Jianan-Li/Bus-Stop-Kiosk/Electrical Design/Bus Stop Kiosk PCB Rev. 1/Bus Stop Kiosk PCB Rev.1 BOM.xlsx

PCB Rev. 1 Bill of Material
Ref Des | Manufacturer P/N | Manufacturer | Description | Package
R1 | LRMAM1206-R001FT5 | TT Electronics/Welwyn | RES SMD 0.001 OHM 1% 1W | 1206
R2, R13 | RC0603FR-07100KL | Yageo | RES SMD 100K OHM 1% 1/10W | 0603
R3 | RC0603FR-071K07L | Yageo | RES SMD 1.07K OHM 1% 1/10W | 0603
R4 | RC0603FR-075K62L | Yageo | RES SMD 5.62K OHM 1% 1/10W | 0603
R5 | RC0603FR-071M21L | Yageo | RES SMD 1.21M OHM 1% 1/10W | 0603
R6 | RC0603FR-07383KL | Yageo | RES SMD 383K OHM 1% 1/10W | 0603
R7, R8, R12, R14 | RC0603FR-0710KL | Yageo | RES SMD 10K OHM 1% 1/10W | 0603
R9 | RC0603FR-0768KL | Yageo | RES SMD 68K OHM 1% 1/10W | 0603
R10, R11 | RC0603FR-07330RL | Yageo | RES SMD 330 OHM 1% 1/10W | 0603
C1, C16, C18, C20 | CC0603KRX7R8BB104 | Yageo | CAP CER 0.1UF 25V X7R | 0603
C2 | EEE-FK1H151P | Panasonic | CAP ALUM 150UF 20% 50V | Radial, Can
C3, C4, C5 | UMK325BJ106MM-T | Taiyo Yuden | CAP CER 10UF 50V X5R | 1210
C6, C9 | CC1206KRX7R9BB473 | Yageo | CAP CER 0.047UF 50V X7R | 1206
C7 | CC0603KRX7R8BB474 | Yageo | CAP CER 0.47UF 25V X7R | 0603
C8 | CC0603KRX7R9BB472 | Yageo | CAP CER 4700PF 50V X7R | 0603
C10 | GRM32ER61A476KE20L | Murata | CAP CER 47UF 10V X5R | 1210
C11, C12 | T520D337M006ATE015 | Kemet | CAP TANT POLY 330UF 6.3V | 2917 (D)
C13 | CC1210MKX7R8BB226 | Yageo | CAP CER 22UF 25V X7R | 1210
C14 | CC0603KRX7R9BB332 | Yageo | CAP CER 3300PF 50V X7R | 0603
C15 | LMK212BJ226MG-T | Taiyo Yuden | CAP CER 22UF 10V X5R | 0805
C17, C19 | CC0603KRX7R8BB105 | Yageo | CAP CER 1UF 25V X7R | 0603
C21, C22 | CC0603JRNPO9BN220 | Yageo | CAP CER 22PF 50V NPO | 0603
D1 | LTST-C195KGJRKT | Lite-On Inc. | LED GREEN/RED CLEAR 0606 | 0606
Q1 | PT17-21C/L41/TR8 | Everlight Electronics Co Ltd | PHOTOTRANSISTOR FLAT CLEAR | 0805
Y1 | ABM8G-16.000MHZ-18-D2Y-T | Abracon LLC | Crystal 16.0000MHz 20ppm 18pF | 4-SMD
U1 | INA226AIDGSR | Texas Instruments | IC MONITOR PWR/CURR BIDIR | 10-MSOP
U2 | LMZ22010TZ/NOPB | Texas Instruments | IC BUCK SYNC 20V 10A | TO-PMOD-11
U3 | LMZ21701SILT | Texas Instruments | DC/DC CONVERTER 0.9-6V 6W | 8-SMD
U4 | IMP002-S-US-TR | Electric Imp Inc. | IMP 802.11B/G/N NODE MODULE | 35-SMD
U5 | ATMEGA328P-AU | Atmel | IC MCU 8BIT 32KB FLASH | 32-TQFP
S1 | KSC241JLFS | C&K Components | SWITCH TACTILE SPST-NO 0.05A 32V
J1, J2 | OSTOQ025351 | On Shore Technology Inc. | TERM BLOCK HDR 2POS R/A 5.08MM
J3, J4, J5 | B4B-XH-A(LF)(SN) | JST Sales America Inc. | CONN HEADER XH TOP 4POS 2.5MM
J6 | 302-S161 | On Shore Technology Inc. | CONN HEADER VERT 16POS GOLD
J7 | 67996-406HLF | FCI | CONN HEADER 6POS .100 STR TIN
PCB Rev. 2 Bill of Material
Ref Des | Manufacturer P/N | Manufacturer | Description | Package
R1, R15. R16 | LRMAM1206-R001FT5 | TT Electronics/Welwyn | RES SMD 0.001 OHM 1% 1W | 1206
R2, R17, R22, R28 | RC0603FR-07100KL | Yageo | RES SMD 100K OHM 1% 1/10W | 0603
R3, R23, R27, R29, R30 | RC0603FR-0710KL | Yageo | RES SMD 10K OHM 1% 1/10W | 0603
R4, R5 | RC0402FR-075K1L | Yageo | RES SMD 5.1K OHM 1% 1/16W | 0402
R6 | RC0402FR-07536KL | Yageo | RES SMD 536K OHM 1% 1/16W | 0402
R7, R9 | RC0402FR-07100KL | Yageo | RES SMD 100K OHM 1% 1/16W | 0402
R8 | RMCF0402FT1M20 | Stackpole Electronics Inc. | RES SMD 1.2M OHM 1% 1/16W | 0402
R10 | RMCF0402FT1M00 | Stackpole Electronics Inc. | RES SMD 1M OHM 1% 1/16W | 0402
R11 | RL1206FR-070R05L | Yageo | RES SMD 0.05 OHM 1% 1/4W | 1206
R12 | ERA-3AEB3163V | Panasonic Electronic Components | RES SMD 316K OHM 0.1% 1/10W | 0603
R13 | RC0402FR-07174KL | Yageo | RES SMD 174K OHM 1% 1/16W | 0402
R14 | RT0603BRD07100KL | Yageo | RES SMD 100K OHM 0.1% 1/10W | 0603
R18 | RC0603FR-071K07L | Yageo | RES SMD 1.07K OHM 1% 1/10W | 0603
R19 | RC0603FR-075K76L | Yageo | RES SMD 5.76K OHM 1% 1/10W | 0603
R20 | RC0603FR-071M21L | Yageo | RES SMD 1.21M OHM 1% 1/10W | 0603
R21 | RC0603FR-07383KL | Yageo | RES SMD 383K OHM 1% 1/10W | 0603
R24 | RC0603FR-0768KL | Yageo | RES SMD 68K OHM 1% 1/10W | 0603
R25, R26 | RC0603FR-07330RL | Yageo | RES SMD 330 OHM 1% 1/10W | 0603
C1, C11, C12, C25, C28, C30, C32 | CC0603KRX7R8BB104 | Yageo | CAP CER 0.1UF 25V X7R | 0603
C2, C3, C4 | T521X107M025ATE060 | Kemet | CAP TANTALUM 100UF 25V | 2917 (D)
C5, C7, C14, C15 | UMK325BJ106MM-T | Taiyo Yuden | CAP CER 10UF 50V X5R | 1210
C6 | UMK212B7105KG-T | Taiyo Yuden | CAP CER 1UF 50V X7R | 0805
C8 | CC0603KRX5R5BB475 | Yageo | CAP CER 4.7UF 6.3V X5R | 0603
C9, C10 | T521D107M020ATE055 | Kemet | CAP TANTALUM 100UF 20V | 2917 (D)
C13 | EEE-FK1H151P | Panasonic | CAP ALUM 150UF 20% 50V | Radial, Can
C16 | CC0603KRX7R8BB474 | Yageo | CAP CER 0.47UF 25V X7R | 0603
C17 | CC0603KRX7R9BB472 | Yageo | CAP CER 4700PF 50V X7R | 0603
C18 | CC1206KRX7R9BB473 | Yageo | CAP CER 0.047UF 50V X7R | 1206
C19 | GRM32ER61A476KE20L | Murata | CAP CER 47UF 10V X5R | 1210
C20, C21 | T520D337M006ATE015 | Kemet | CAP TANT POLY 330UF 6.3V | 2917 (D)
C22 | CC1210MKX7R8BB226 | Yageo | CAP CER 22UF 25V X7R | 1210
C23 | LMK212BJ226MG-T | Taiyo Yuden | CAP CER 22UF 10V X5R | 0805
C24 | CC0603KRX7R9BB332 | Yageo | CAP CER 3300PF 50V X7R | 0603
C26, C27 | CC0603JRNPO9BN220 | Yageo | CAP CER 22PF 50V NPO | 0603
C29, C31 | CC0603KRX7R8BB105 | Yageo | CAP CER 1UF 25V X7R | 0603
L1 | XAL6060-103MEB | Coilcraft | Power Inductor 10UH | 6060
F1, F2 | 0603SFP400F/32-2 | TE Connectivity Raychem Circuit Protection | FUSE BOARD MOUNT 4A 32VDC | 0603
D1 | CMHZ4697 TR | Central Semiconductor Corp | DIODE ZENER 10V 500MW | SOD-123
D2 | LTST-C191KGKT | Lite-On Inc. | LED GREEN CLEAR | 0603
D3 | LTST-C191KRKT | Lite-On Inc. | LED RED CLEAR | 0603
D4 | CMSH3-40MA TR13 | Central Semiconductor Corp | DIODE SCHOTTKY 40V 3A | SMA
D5, D7 | 1N4148W-7-F | Diodes Incorporated | DIODE GEN PURP 100V 300MA | SOD-123
D6 | CMHZ4691 TR | Central Semiconductor Corp | DIODE ZENER 6.2V 500MW | SOD-123
D8 | LTST-C195KGJRKT | Lite-On Inc. | LED GREEN/RED CLEAR 0606 | 0606
Q1 | SI2319CDS-T1-GE3 | Vishay Siliconix | MOSFET P-CH 40V 4.4A | SOT-23
Q2 | PT17-21C/L41/TR8 | Everlight Electronics Co Ltd | PHOTOTRANSISTOR FLAT CLEAR | 0805
Y1 | ABM8G-16.000MHZ-18-D2Y-T | Abracon LLC | Crystal 16.0000MHz 20ppm 18pF | 4-SMD
U1, U3, U4 | INA226AIDGSR | Texas Instruments | IC MONITOR PWR/CURR BIDIR | 10-MSOP
U2 | LT3652IMSE#PBF | Linear Technology | IC BATT CHARGER SOLAR 2A 12MSOP | 12-MSOP-EP
U5 | LMZ12010TZ/NOPB | Texas Instruments | IC BUCK SYNC 20V 10A | TO-PMOD-11
U6 | LMZ21701SILT | Texas Instruments | DC/DC CONVERTER 0.9-6V 6W | 8-SMD
U7 | ATMEGA328P-AU | Atmel | IC MCU 8BIT 32KB FLASH | 32-TQFP
U8 | IMP002-S-US-TR | Electric Imp Inc. | IMP 802.11B/G/N NODE MODULE | 35-SMD
U9 | 568-5479-1-ND | NXP Semiconductors | TXRX TRANSLATING 3ST 8VSSOP | 8-VSSOP
S1 | KSC241JLFS | C&K Components | SWITCH TACTILE SPST-NO 0.05A 32V
J1, J2, J4 | OSTOQ025351 | On Shore Technology Inc. | TERM BLOCK HDR 2POS R/A 5.08MM
J3 | OSTOQ045451 | On Shore Technology Inc. | TERM BLOCK HDR 4POS R/A 5.08MM
J5, J6, J7 | B4B-XH-A(LF)(SN) | JST Sales America Inc. | CONN HEADER XH TOP 4POS 2.5MM
J8 | 302-S161 | On Shore Technology Inc. | CONN HEADER VERT 16POS GOLD
J9 | 67996-406HLF | FCI | CONN HEADER 6POS .100 STR TIN
