Jianan-Li/Bus-Stop-Kiosk/Mechanical Design/LED Matrix Enclosure/LED Frame Assembly.SLDASM

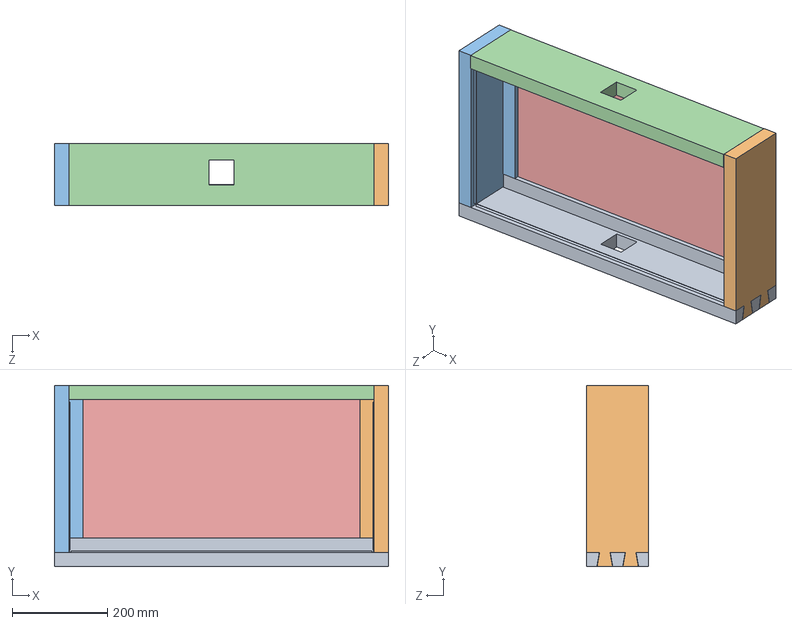
[picture p1: CAD file, 2016-12-03]
Mechanical Design/LED Matrix Enclosure/LED Frame Assembly.SLDASM
700.1 x 380.0 x 131.0 mm
Bottom
Right
Left
Top
Back
