Jianan-Li/Bus-Stop-Kiosk/Mechanical Design/Bus Map Enclosure/Assem1.SLDASM

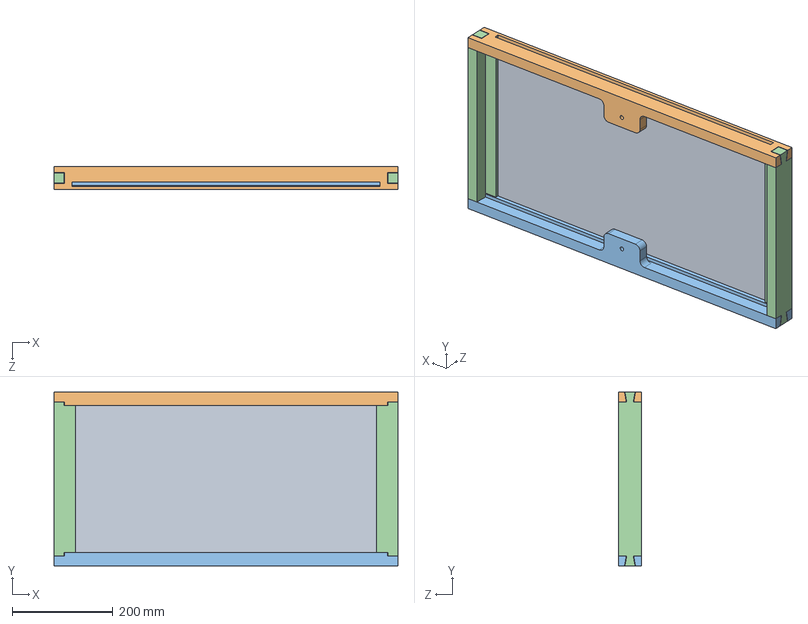
[picture p2: CAD file, 2016-12-03]
Mechanical Design/Bus Map Enclosure/Assem1.SLDASM
682.7 x 344.8 x 46.0 mm
Plexiglass
MapTop
MapBottom
MapSide x 2
