Jianan-Li/Bus-Stop-Kiosk/Mechanical Design/Bus Map Enclosure/MapTop.sldprt

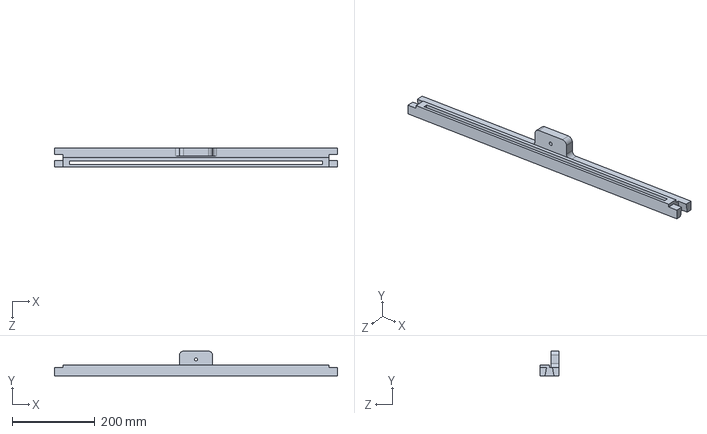
[picture p3: CAD file, 2016-12-03]
Mechanical Design/Bus Map Enclosure/MapTop.sldprt
682.7 x 60.0 x 46.0 mm
