Jianan-Li/Bus-Stop-Kiosk/Mechanical Design/LED Matrix Enclosure/Bottom.SLDPRT

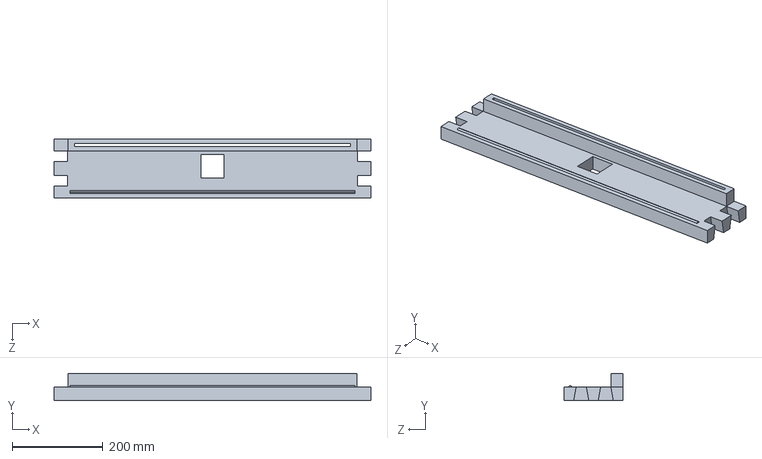
[picture p4: CAD file, 2016-12-03]
Mechanical Design/LED Matrix Enclosure/Bottom.SLDPRT
700.0 x 60.0 x 130.0 mm
