Jianan-Li/Bus-Stop-Kiosk/Mechanical Design/Bus Map Enclosure/MapSide.SLDPRT

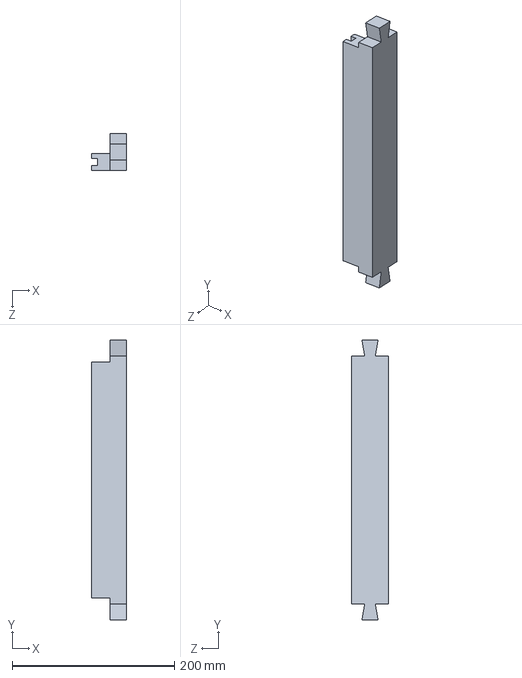
[picture p5: CAD file, 2016-12-03]
Mechanical Design/Bus Map Enclosure/MapSide.SLDPRT
42.9 x 344.8 x 46.0 mm
