Jianan-Li/Bus-Stop-Kiosk/Mechanical Design/LED Matrix Enclosure/Left.SLDPRT

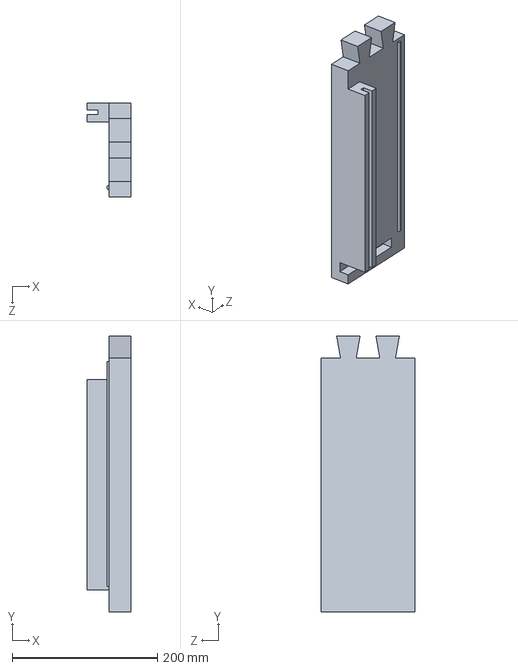
[picture p6: CAD file, 2016-12-03]
Mechanical Design/LED Matrix Enclosure/Left.SLDPRT
60.0 x 380.0 x 130.0 mm
