Jianan-Li/Bus-Stop-Kiosk/Mechanical Design/Bus Map Enclosure/Plexiglass.SLDPRT

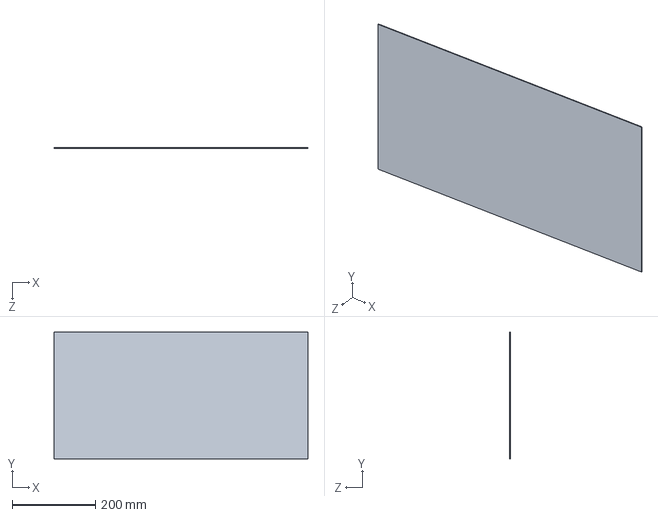
[picture p7: CAD file, 2016-12-03]
Mechanical Design/Bus Map Enclosure/Plexiglass.SLDPRT
609.6 x 304.8 x 1.59 mm
