Jianan-Li/Bus-Stop-Kiosk/Mechanical Design/LED Matrix Enclosure/Back.SLDPRT

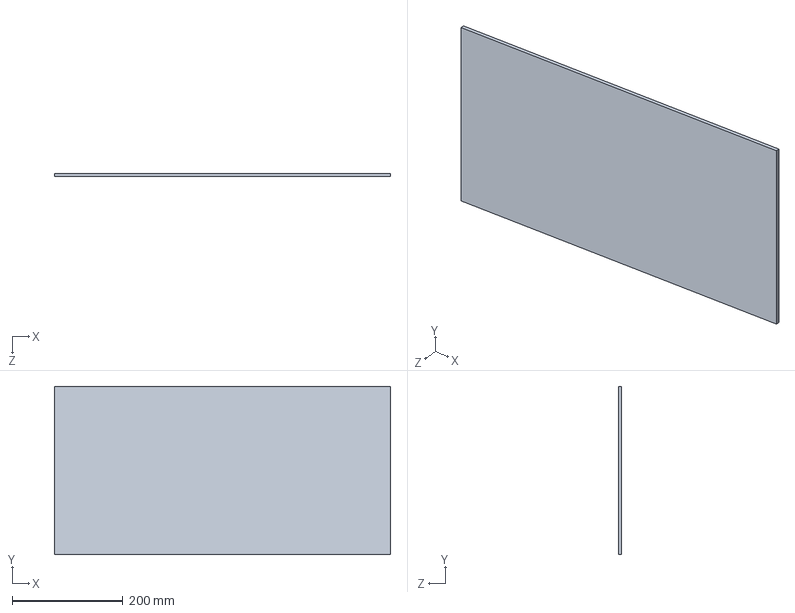
[picture p8: CAD file, 2016-12-03]
Mechanical Design/LED Matrix Enclosure/Back.SLDPRT
608.0 x 304.0 x 6.30 mm
