Jianan-Li/Bus-Stop-Kiosk/Mechanical Design/Bus Map Enclosure/MapBottom.sldprt

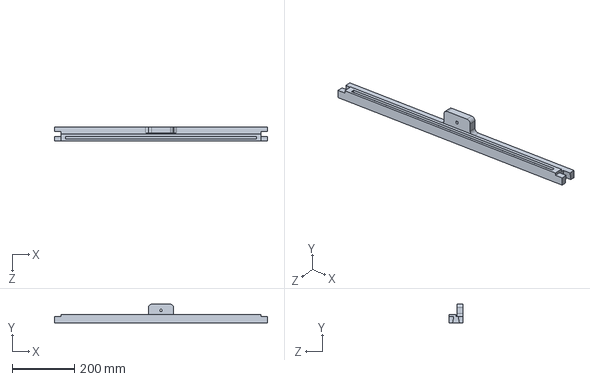
[picture p9: CAD file, 2016-12-03]
Mechanical Design/Bus Map Enclosure/MapBottom.sldprt
682.7 x 60.0 x 46.0 mm
