Jianan-Li/Bus-Stop-Kiosk/Mechanical Design/LED Matrix Enclosure/Top.SLDPRT

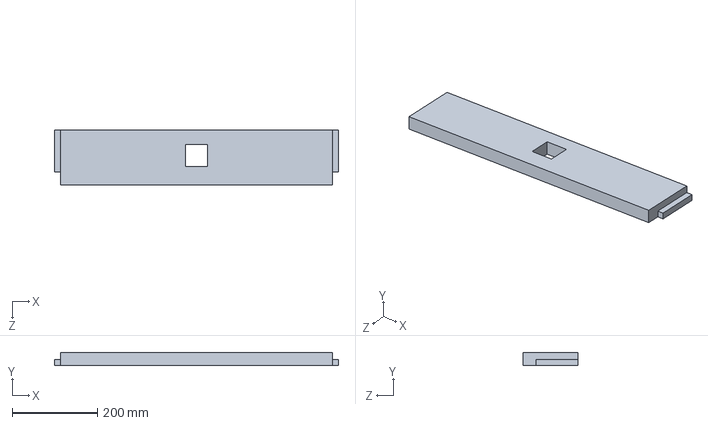
[picture p10: CAD file, 2016-12-03]
Mechanical Design/LED Matrix Enclosure/Top.SLDPRT
668.0 x 30.0 x 130.0 mm
