Jianan-Li/Bus-Stop-Kiosk/(list of files, cad)

Other CAD files:
Mechanical Design/LED Matrix Enclosure/Right.SLDPRT
