Jianan-Li/Bus-Stop-Kiosk/Electrical Design/Bus Stop Kiosk PCB Rev. 1/Bus Stop Kiosk Rev. 1.brd

## EAGLE design Electrical Design/Bus Stop Kiosk PCB Rev. 1/Bus Stop Kiosk Rev. 1.brd (2016-12-03)

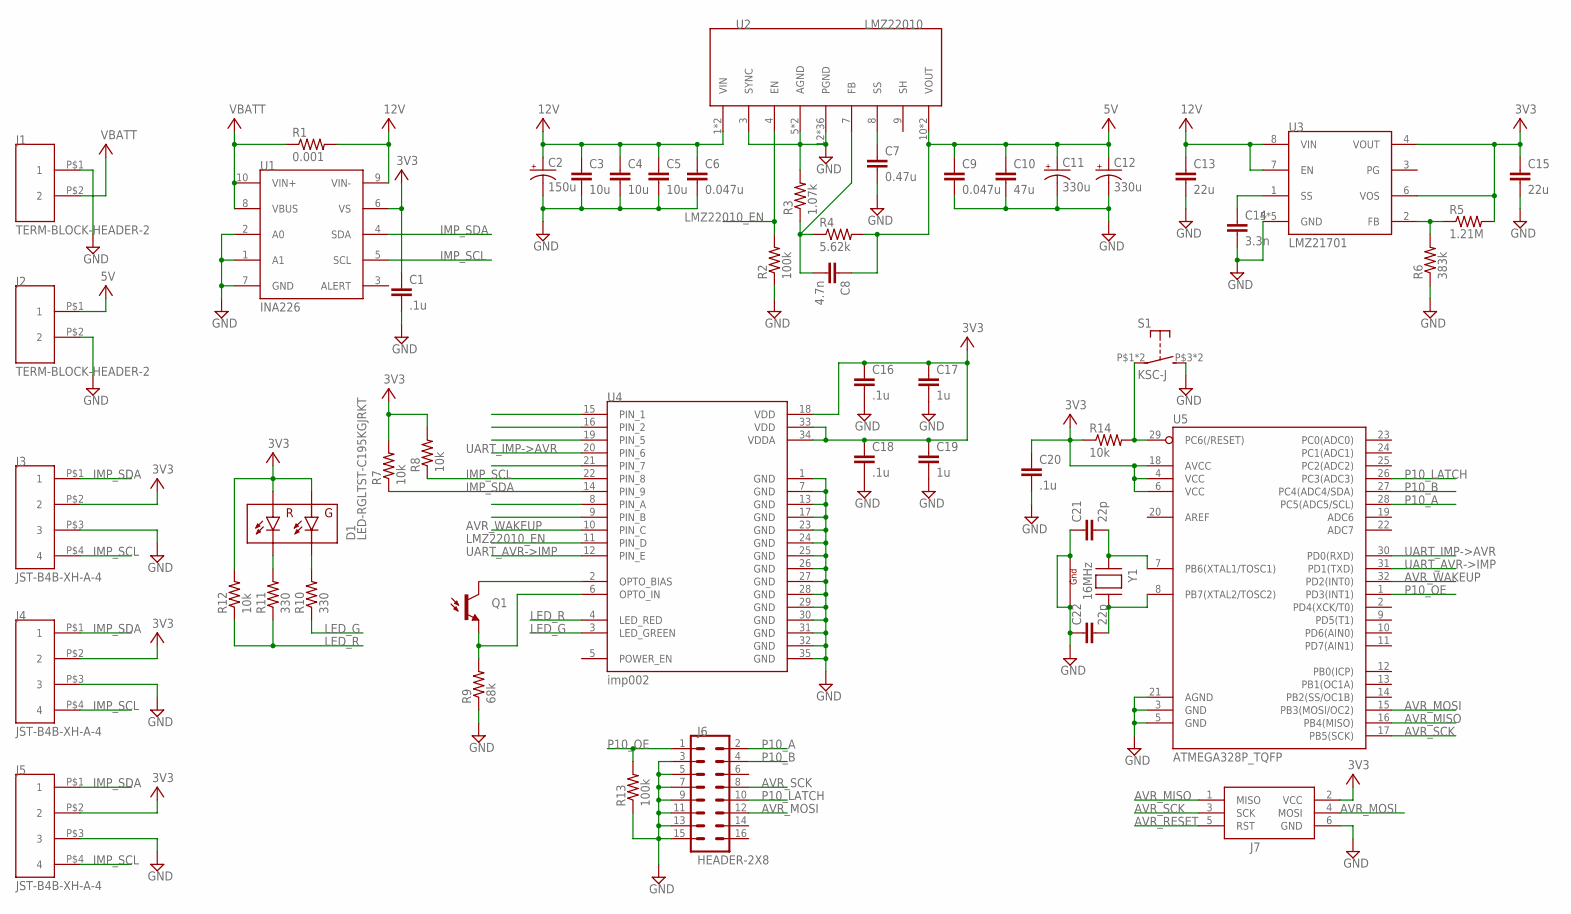
[picture p11: schematic Bus Stop Kiosk Rev. 1.sch]

Parts:
C1, C16, C18, C20: .1u; C0603K
C2: 150u; PANASONIC_G
C3, C4, C5: 10u; C1210K
C6, C9: 0.047u; C1206K
C7: 0.47u; C0603K
C8: 4.7n; C0603K
C10: 47u; C1210K
C11, C12: 330u; EIA7343
C13: 22u; C1210K
C14: 3.3n; C0603K
C15: 22u; C0805K
C17, C19: 1u; C0603K
C21, C22: 22p; C0603K
D1: LED-RGLTST-C195KGJRKT; LTST-C195KGJRKT
J1, J2: TERM-BLOCK-HEADER-2; TERM-BLOCK-HDR-2
J3, J4, J5: JST-B4B-XH-A-4
J6: HEADER-2X8; HEADER-2X8-SHROUDED
J7: AVRISP-6; AVRISP
Q1: PHOTOTRANSISTORPT17-21C-L41-TR8; PT17-21C-L41-TR8
R1: 0.001; R1206
R2, R13: 100k; R0603
R3: 1.07k; R0603
R4: 5.62k; R0603
R5: 1.21M; R0603
R6: 383k; R0603
R7, R8, R12, R14: 10k; R0603
R9: 68k; R0603
R10, R11: 330; R0603
S1: KSC-J; C&K-KSC
U1: INA226; VSSOP-10
U2: LMZ22010; TO-PMOD-11
U3: LMZ21701; SIL0008E
U4: imp002; ELECTRIC_IMP_IMP002
U5: ATMEGA328P_TQFP; TQFP32-08
Y1: 16MHz; NX3225

Connections:
3V3: C1.1, C15.1, C16.1, C17.1, C18.1, C19.1, C20.1, D1.P$1 (GA), D1.P$2 (RA), J3.P$2 (2), J4.P$2 (2), J5.P$2 (2), J7.2 (VCC), R5.2, R7.2, R8.2, R12.2, R14.1, U1.6 (VS), U3.4 (VOUT), U3.6 (VOS), U4.18 (VDD), U4.33 (VDD), U4.34 (VDDA), U5.4 (VCC), U5.6 (VCC), U5.18 (AVCC)
5V: C8.1, C9.1, C10.1, C11.A (+), C12.A (+), J2.P$1 (1), R4.2, U2.10 (VOUT), U2.11 (VOUT)
12V: C2.+, C3.1, C4.1, C5.1, C6.1, C13.1, R1.2, U1.9 (VIN-), U2.1 (VIN), U2.2 (VIN), U3.7 (EN), U3.8 (VIN)
ADC1: U4.8 (PIN_A)
ADC2: U4.9 (PIN_B)
AVR_MISO: J7.1 (MISO), U5.16 (PB4(MISO))
AVR_MOSI: J6.12, J7.4 (MOSI), U5.15 (PB3(MOSI/OC2))
AVR_RESET: J7.5 (RST), R14.2, S1.P$1, S1.P$2, U5.29 (PC6(/RESET))
AVR_SCK: J6.8, J7.3 (SCK), U5.17 (PB5(SCK))
AVR_WAKEUP: U4.10 (PIN_C), U5.32 (PD2(INT0))
C21: C21.2, U5.7 (PB6(XTAL1/TOSC1)), Y1.1 (X1)
GND: C1.2, C2.-, C3.2, C4.2, C5.2, C6.2, C7.2, C9.2, C10.2, C11.C (-), C12.C (-), C13.2, C14.2, C15.2, C16.2, C17.2, C18.2, C19.2, C20.2, C21.1, C22.1, J1.P$1 (1), J2.P$2 (2), J3.P$3 (3), J4.P$3 (3), J5.P$3 (3), J6.3, J6.5, J6.7, J6.9, J6.11, J6.13, J6.15, J7.6 (GND), R2.1, R3.2, R6.1, R9.1, R13.1, S1.P$3 (S), S1.P$4 (S), U1.1 (A1), U1.2 (A0), U1.7 (GND), U2.3 (SYNC), U2.5 (AGND), U2.6 (AGND), U2.12 (PGND), U2.P$1 (PGND), U2.P$2 (PGND), U2.P$3 (PGND), U2.P$4 (PGND), U2.P$5 (PGND), U2.P$6 (PGND), U2.P$7 (PGND), U2.P$8 (PGND), U2.P$9 (PGND), U2.P$10 (PGND), U2.P$11 (PGND), U2.P$12 (PGND), U2.P$13 (PGND), U2.P$14 (PGND), U2.P$15 (PGND), U2.P$16 (PGND), U2.P$17 (PGND), U2.P$18 (PGND), U2.P$19 (PGND), U2.P$20 (PGND), U2.P$21 (PGND), U2.P$22 (PGND), U2.P$23 (PGND), U2.P$24 (PGND), U2.P$25 (PGND), U2.P$26 (PGND), U2.P$27 (PGND), U2.P$28 (PGND), U2.P$29 (PGND), U2.P$30 (PGND), U2.P$31 (PGND), U2.P$32 (PGND), U2.P$33 (PGND), U2.P$34 (PGND), U2.P$35 (PGND), U3.5 (GND), U3.9 (GND), U3.10 (GND), U3.11 (GND), U3.12 (GND), U4.1 (GND), U4.7 (GND), U4.13 (GND), U4.17 (GND), U4.23 (GND), U4.24 (GND), U4.25 (GND), U4.26 (GND), U4.27 (GND), U4.28 (GND), U4.29 (GND), U4.30 (GND), U4.31 (GND), U4.32 (GND), U4.35 (GND), U5.3 (GND), U5.5 (GND), U5.21 (AGND), Y1.2 (G2), Y1.4 (G1)
IMP_SCL: J3.P$4 (4), J4.P$4 (4), J5.P$4 (4), R8.1, U1.5 (SCL), U4.22 (PIN_8)
IMP_SDA: J3.P$1 (1), J4.P$1 (1), J5.P$1 (1), R7.1, U1.4 (SDA), U4.14 (PIN_9)
LED_G: R10.1, U4.3 (LED_GREEN)
LED_R: R11.1, R12.1, U4.4 (LED_RED)
LMZ22010_EN: R2.2, U2.4 (EN), U4.11 (PIN_D)
unnamed: Q1.C, U4.2 (OPTO_BIAS)
unnamed: Q1.E, R9.2, U4.6 (OPTO_IN)
unnamed: D1.P$3 (GC), R10.2
unnamed: D1.P$4 (RC), R11.2
unnamed: C14.1, U3.1 (SS)
unnamed: C8.2, R3.1, R4.1, U2.7 (FB)
unnamed: C7.1, U2.8 (SS)
unnamed: R5.1, R6.2, U3.2 (FB)
unnamed: C22.2, U5.8 (PB7(XTAL2/TOSC2)), Y1.3 (X2)
P10_A: J6.2, U5.28 (PC5(ADC5/SCL))
P10_B: J6.4, U5.27 (PC4(ADC4/SDA))
P10_LATCH: J6.10, U5.26 (PC3(ADC3))
P10_OE: J6.1, R13.2, U5.1 (PD3(INT1))
UART_AVR->IMP: U4.12 (PIN_E), U5.31 (PD1(TXD))
UART_IMP->AVR: U4.20 (PIN_6), U5.30 (PD0(RXD))
VBATT: J1.P$2 (2), R1.1, U1.8 (VBUS), U1.10 (VIN+)

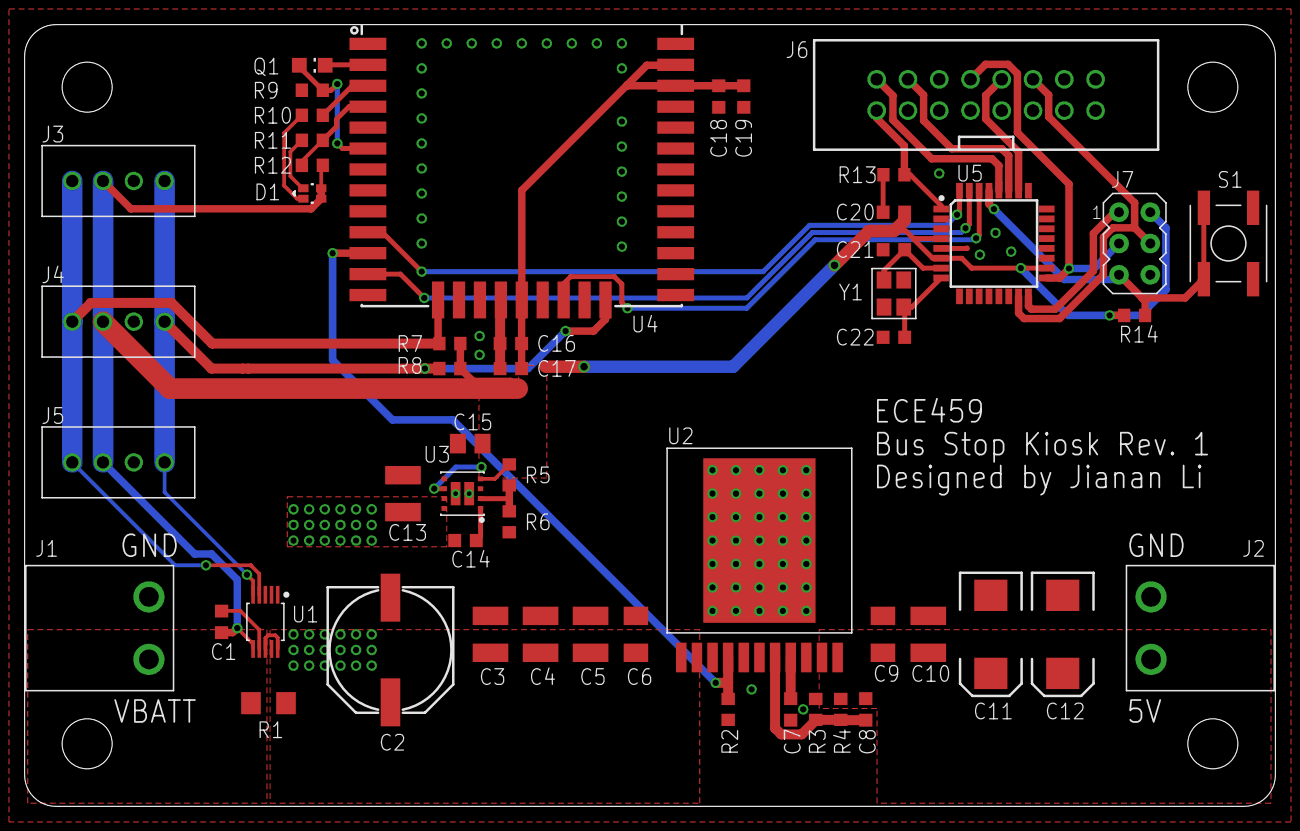
[picture p12: board Bus Stop Kiosk Rev. 1.brd from above]

Board: 2 copper layers, 101.6 x 63.5 mm, 52 parts (0 on the bottom side), 31 nets.
