Jianan-Li/Bus-Stop-Kiosk/Electrical Design/Bus Stop Kiosk PCB Rev. 2/Bus Stop Kiosk Rev. 2.brd

## EAGLE design Electrical Design/Bus Stop Kiosk PCB Rev. 2/Bus Stop Kiosk Rev. 2.brd (2016-12-03)

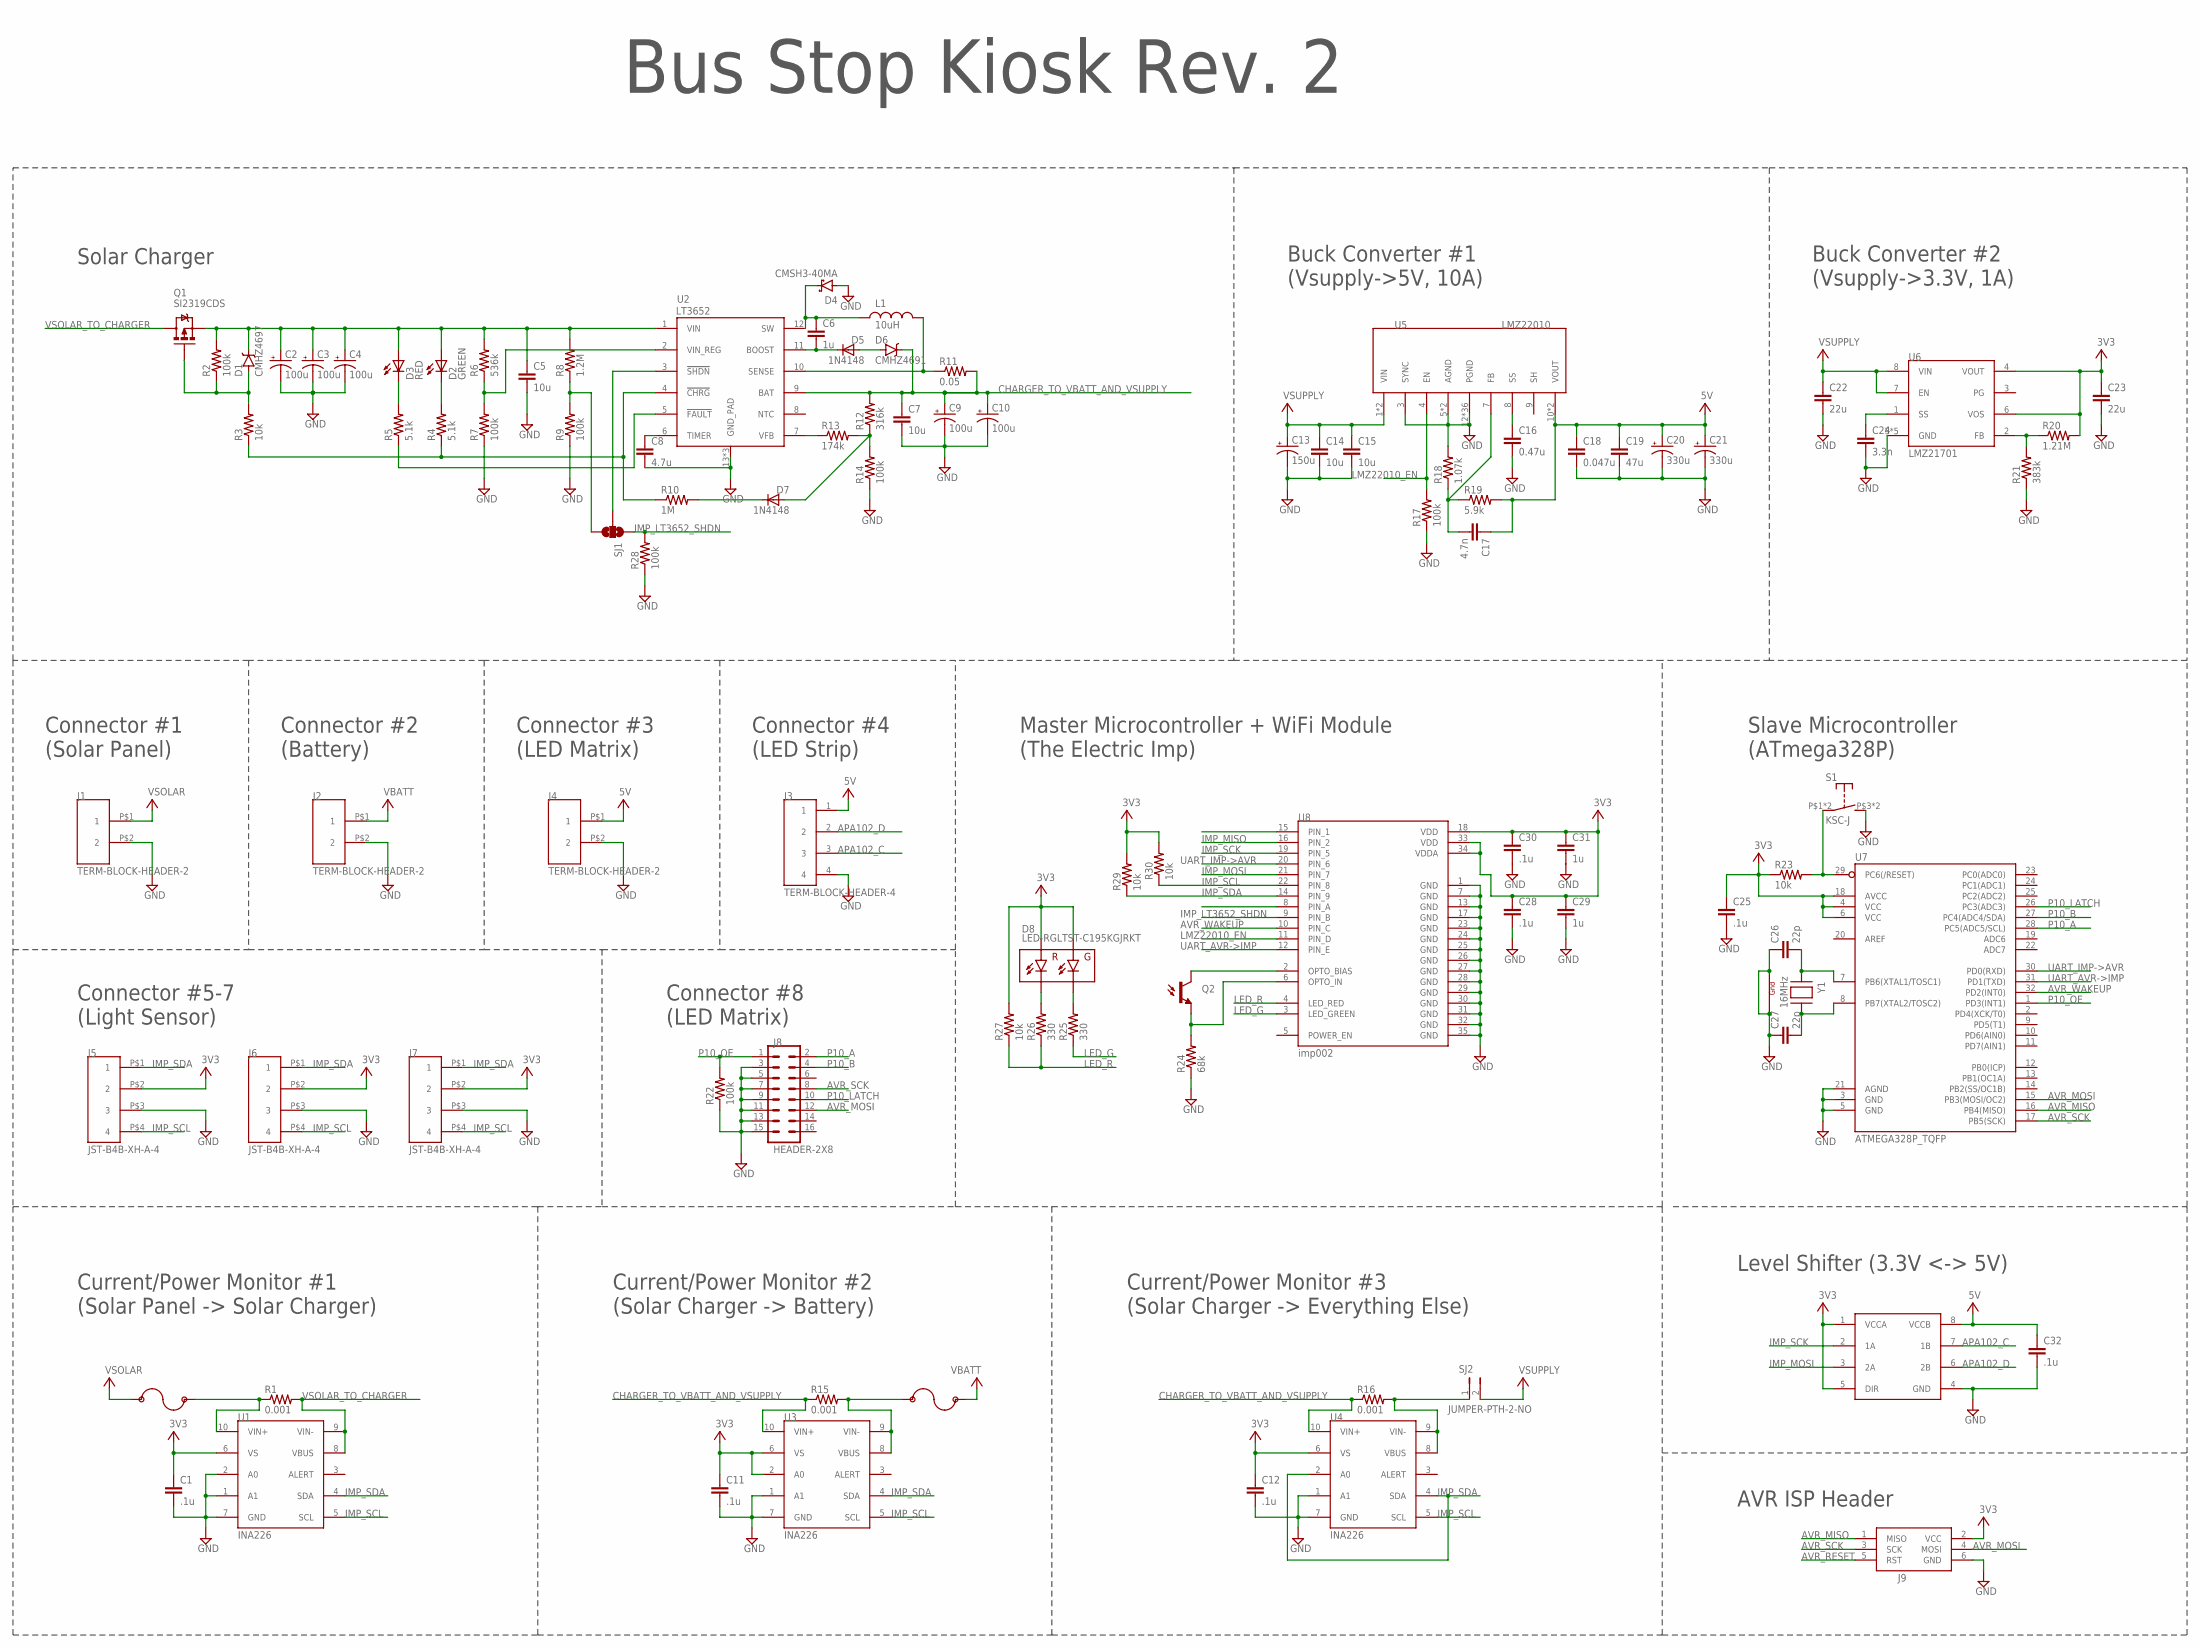
[picture p13: schematic Bus Stop Kiosk Rev. 2.sch]

Parts:
C1, C11, C12, C25, C28, C30, C32: .1u; C0603K
C2, C3, C4, C9, C10: 100u; EIA7343
C5, C7, C14, C15: 10u; C1210K
C6: 1u; C0805K
C8: 4.7u; C0603K
C13: 150u; PANASONIC_G
C16: 0.47u; C0603K
C17: 4.7n; C0603K
C18: 0.047u; C1206K
C19: 47u; C1210K
C20, C21: 330u; EIA7343
C22: 22u; C1210K
C23: 22u; C0805K
C24: 3.3n; C0603K
C26, C27: 22p; C0603K
C29, C31: 1u; C0603K
D1: CMHZ4697; SOD-123
D2: GREEN; CHIP-LED0603
D3: RED; CHIP-LED0603
D4: CMSH3-40MA; SMA-DIODE
D5, D7: 1N4148; SOD-123
D6: CMHZ4691; SOD-123
D8: LED-RGLTST-C195KGJRKT; LTST-C195KGJRKT
F1, F2: 4A; 0603
J1, J2, J4: TERM-BLOCK-HEADER-2; TERM-BLOCK-HDR-2
J3: TERM-BLOCK-HEADER-4; OSTOQ045451
J5, J6, J7: JST-B4B-XH-A-4
J8: HEADER-2X8; HEADER-2X8-SHROUDED
J9: AVRISP-6; AVRISP
L1: 10uH; INDUCTOR-6.86X6.47
Q1: SI2319CDS; SOT-23-3
Q2: PHOTOTRANSISTORPT17-21C-L41-TR8; PT17-21C-L41-TR8
R1, R15, R16: 0.001; R1206
R2, R14, R17, R22, R28: 100k; R0603
R3, R23, R27, R29, R30: 10k; R0603
R4, R5: 5.1k; R0402
R6: 536k; R0402
R7, R9: 100k; R0402
R8: 1.2M; R0402
R10: 1M; R0402
R11: 0.05; R1206
R12: 316k; R0603
R13: 174k; R0402
R18: 1.07k; R0603
R19: 5.9k; R0603
R20: 1.21M; R0603
R21: 383k; R0603
R24: 68k; R0603
R25, R26: 330; R0603
S1: KSC-J; C&K-KSC
SJ1: JUMPER-PAD-3-NOYES_SILK; PAD-JUMPER-3-NO_YES_SILK
SJ2: JUMPER-PTH-2-NO; PTH-JUMPER-2-NO_NO_SILK
U1, U3, U4: INA226; VSSOP-10
U2: LT3652; MSOP-12_GND
U5: LMZ22010; TO-PMOD-11
U6: LMZ21701; SIL0008E
U7: ATMEGA328P_TQFP; TQFP32-08
U8: imp002; ELECTRIC_IMP_IMP002
U9: 74LVC2T45; VSSOP-8
Y1: 16MHz; NX3225

Connections:
3V3: C1.1, C11.1, C12.1, C23.1, C25.1, C28.1, C29.1, C30.1, C31.1, D8.P$1 (GA), D8.P$2 (RA), J5.P$2 (2), J6.P$2 (2), J7.P$2 (2), J9.2 (VCC), R20.2, R23.1, R27.2, R29.2, R30.2, U1.6 (VS), U3.2 (A0), U3.6 (VS), U4.6 (VS), U6.4 (VOUT), U6.6 (VOS), U7.4 (VCC), U7.6 (VCC), U7.18 (AVCC), U8.18 (VDD), U8.33 (VDD), U8.34 (VDDA), U9.1 (VCCA), U9.5 (DIR)
5V: C17.1, C18.1, C19.1, C20.A (+), C21.A (+), C32.1, J3.1, J4.P$1 (1), R19.2, U5.10 (VOUT), U5.11 (VOUT), U9.8 (VCCB)
ADC1: U8.8 (PIN_A)
APA102_C: J3.3, U9.7 (1B)
APA102_D: J3.2, U9.6 (2B)
AVR_MISO: J9.1 (MISO), U7.16 (PB4(MISO))
AVR_MOSI: J8.12, J9.4 (MOSI), U7.15 (PB3(MOSI/OC2))
AVR_RESET: J9.5 (RST), R23.2, S1.P$1, S1.P$2, U7.29 (PC6(/RESET))
AVR_SCK: J8.8, J9.3 (SCK), U7.17 (PB5(SCK))
AVR_WAKEUP: U7.32 (PD2(INT0)), U8.10 (PIN_C)
BOOST: C6.2, D5.C, U2.11 (BOOST)
C21: C26.2, U7.7 (PB6(XTAL1/TOSC1)), Y1.1 (X1)
CHARGER_TO_VBATT_AND_VSUPPLY: C7.1, C9.A (+), C10.A (+), D6.C, R11.2, R12.2, R15.1, R16.1, U2.9 (BAT), U3.10 (VIN+), U4.10 (VIN+)
CHRG: R3.1, R4.1, R10.1, U2.4 (!CHRG)
FAULT: R5.1, U2.5 (!FAULT)
GND: C1.2, C2.C (-), C3.C (-), C4.C (-), C5.2, C7.2, C8.2, C9.C (-), C10.C (-), C11.2, C12.2, C13.-, C14.2, C15.2, C16.2, C18.2, C19.2, C20.C (-), C21.C (-), C22.2, C23.2, C24.2, C25.2, C26.1, C27.1, C28.2, C29.2, C30.2, C31.2, C32.2, D4.A, J1.P$2 (2), J2.P$2 (2), J3.4, J4.P$2 (2), J5.P$3 (3), J6.P$3 (3), J7.P$3 (3), J8.3, J8.5, J8.7, J8.9, J8.11, J8.13, J8.15, J9.6 (GND), R7.1, R9.1, R14.1, R17.1, R18.2, R21.1, R22.1, R24.1, R28.1, S1.P$3 (S), S1.P$4 (S), U1.1 (A1), U1.2 (A0), U1.7 (GND), U2.13 (GND_PAD), U2.P$1 (GND_PAD), U2.P$2 (GND_PAD), U3.1 (A1), U3.7 (GND), U4.1 (A1), U4.7 (GND), U5.3 (SYNC), U5.5 (AGND), U5.6 (AGND), U5.12 (PGND), U5.P$1 (PGND), U5.P$2 (PGND), U5.P$3 (PGND), U5.P$4 (PGND), U5.P$5 (PGND), U5.P$6 (PGND), U5.P$7 (PGND), U5.P$8 (PGND), U5.P$9 (PGND), U5.P$10 (PGND), U5.P$11 (PGND), U5.P$12 (PGND), U5.P$13 (PGND), U5.P$14 (PGND), U5.P$15 (PGND), U5.P$16 (PGND), U5.P$17 (PGND), U5.P$18 (PGND), U5.P$19 (PGND), U5.P$20 (PGND), U5.P$21 (PGND), U5.P$22 (PGND), U5.P$23 (PGND), U5.P$24 (PGND), U5.P$25 (PGND), U5.P$26 (PGND), U5.P$27 (PGND), U5.P$28 (PGND), U5.P$29 (PGND), U5.P$30 (PGND), U5.P$31 (PGND), U5.P$32 (PGND), U5.P$33 (PGND), U5.P$34 (PGND), U5.P$35 (PGND), U6.5 (GND), U6.9 (GND), U6.10 (GND), U6.11 (GND), U6.12 (GND), U7.3 (GND), U7.5 (GND), U7.21 (AGND), U8.1 (GND), U8.7 (GND), U8.13 (GND), U8.17 (GND), U8.23 (GND), U8.24 (GND), U8.25 (GND), U8.26 (GND), U8.27 (GND), U8.28 (GND), U8.29 (GND), U8.30 (GND), U8.31 (GND), U8.32 (GND), U8.35 (GND), U9.4 (GND), Y1.2 (G2), Y1.4 (G1)
IMP_LT3652_SHDN: R28.2, SJ1.1, U8.9 (PIN_B)
IMP_MISO: U8.16 (PIN_2)
IMP_MOSI: U8.21 (PIN_7), U9.3 (2A)
IMP_SCK: U8.19 (PIN_5), U9.2 (1A)
IMP_SCL: J5.P$4 (4), J6.P$4 (4), J7.P$4 (4), R30.1, U1.5 (SCL), U3.5 (SCL), U4.5 (SCL), U8.22 (PIN_8)
IMP_SDA: J5.P$1 (1), J6.P$1 (1), J7.P$1 (1), R29.1, U1.4 (SDA), U3.4 (SDA), U4.2 (A0), U4.4 (SDA), U8.14 (PIN_9)
LED_G: R25.1, U8.3 (LED_GREEN)
LED_R: R26.1, R27.1, U8.4 (LED_RED)
LMZ22010_EN: R17.2, U5.4 (EN), U8.11 (PIN_D)
unnamed: Q2.C, U8.2 (OPTO_BIAS)
unnamed: Q2.E, R24.2, U8.6 (OPTO_IN)
unnamed: D8.P$3 (GC), R25.2
unnamed: D8.P$4 (RC), R26.2
unnamed: C24.1, U6.1 (SS)
unnamed: D7.C, R10.2
unnamed: C17.2, R18.1, R19.1, U5.7 (FB)
unnamed: C16.1, U5.8 (SS)
unnamed: R20.1, R21.2, U6.2 (FB)
unnamed: R8.1, R9.2, SJ1.3
unnamed: D7.A, R12.1, R13.2, R14.2
unnamed: D3.C, R5.2
unnamed: D1.A, Q1.1 (G), R2.1, R3.2
unnamed: D2.C, R4.2
unnamed: C27.2, U7.8 (PB7(XTAL2/TOSC2)), Y1.3 (X2)
unnamed: D5.A, D6.A
unnamed: F1.2, R1.1, U1.10 (VIN+)
unnamed: R16.2, SJ2.1, U4.8 (VBUS), U4.9 (VIN-)
unnamed: F2.1, R15.2, U3.8 (VBUS), U3.9 (VIN-)
P10_A: J8.2, U7.28 (PC5(ADC5/SCL))
P10_B: J8.4, U7.27 (PC4(ADC4/SDA))
P10_LATCH: J8.10, U7.26 (PC3(ADC3))
P10_OE: J8.1, R22.2, U7.1 (PD3(INT1))
SENSE: L1.P$2 (2), R11.1, U2.10 (SENSE)
SHDN: SJ1.2, U2.3 (!SHDN)
SW: C6.1, D4.C, L1.P$1 (1), U2.12 (SW)
TIMER: C8.1, U2.6 (TIMER)
UART_AVR->IMP: U7.31 (PD1(TXD)), U8.12 (PIN_E)
UART_IMP->AVR: U7.30 (PD0(RXD)), U8.20 (PIN_6)
VBATT: F2.2, J2.P$1 (1)
VFB: R13.1, U2.7 (VFB)
VIN: C2.A (+), C3.A (+), C4.A (+), C5.1, D1.C, D2.A, D3.A, Q1.2 (S), R2.2, R6.2, R8.2, U2.1 (VIN)
VIN_REG: R6.1, R7.2, U2.2 (VIN_REG)
VSOLAR: F1.1, J1.P$1 (1)
VSOLAR_TO_CHARGER: Q1.3 (D), R1.2, U1.8 (VBUS), U1.9 (VIN-)
VSUPPLY: C13.+, C14.1, C15.1, C22.1, SJ2.2, U5.1 (VIN), U5.2 (VIN), U6.7 (EN), U6.8 (VIN)

Notes on the sheet:
Solar Charger
Current/Power Monitor #1 (Solar Panel -> Solar Charger)
Current/Power Monitor #2 (Solar Charger -> Battery)
Current/Power Monitor #3 (Solar Charger -> Everything Else)
Buck Converter #1 (Vsupply->5V, 10A)
Connector #1 (Solar Panel)
Connector #2 (Battery)
Connector #3 (LED Matrix)
Connector #4 (LED Strip)
Buck Converter #2 (Vsupply->3.3V, 1A)
Master Microcontroller + WiFi Module (The Electric Imp)
Connector #5-7 (Light Sensor)
Level Shifter (3.3V <-> 5V)
Connector #8 (LED Matrix)
Slave Microcontroller (ATmega328P)
AVR ISP Header
Bus Stop Kiosk Rev. 2

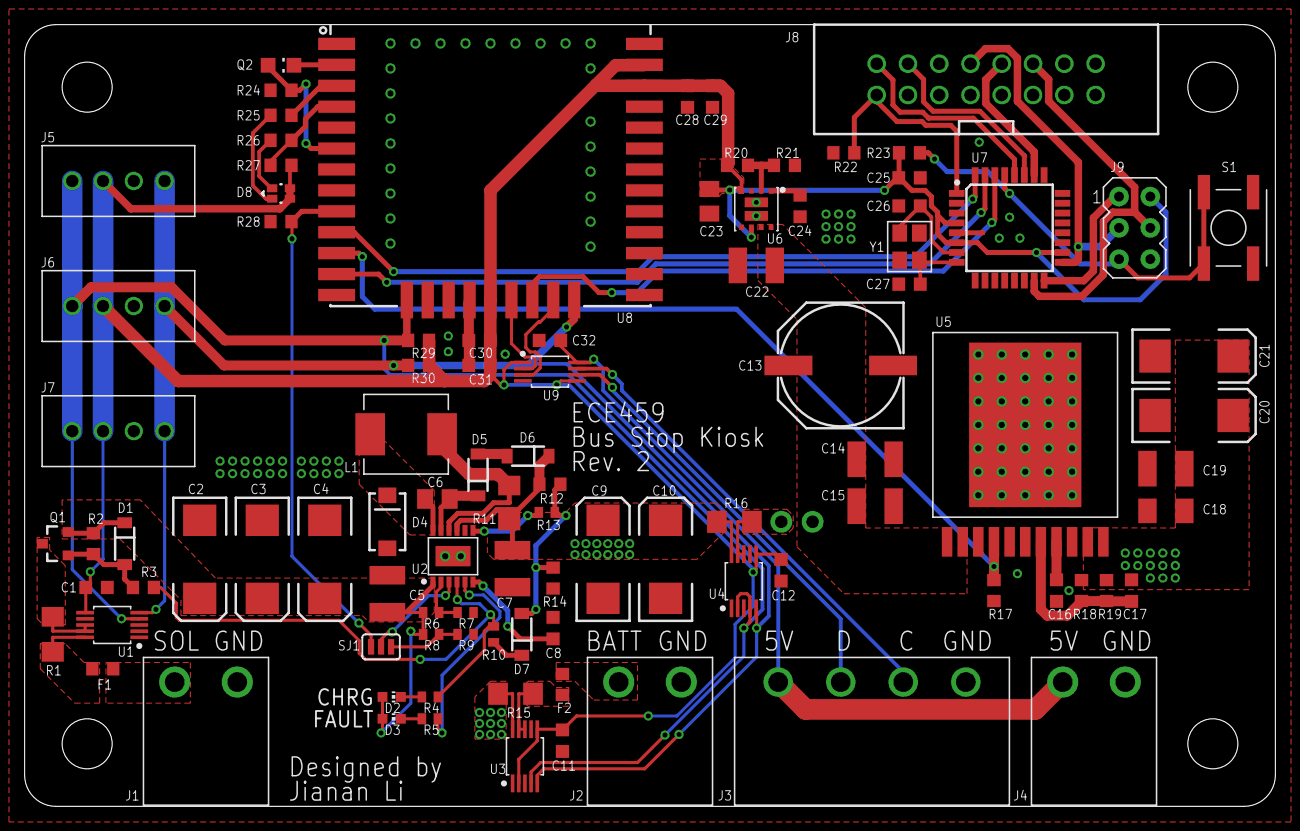
[picture p14: board Bus Stop Kiosk Rev. 2.brd from above]

Board: 2 copper layers, 101.6 x 63.5 mm, 97 parts (0 on the bottom side), 59 nets.
